RaymondBE/Electiva_Mecatronica_Raymond_Bautista_2019-8348-/README.md

# Electiva_Mecatronica_Raymond_Bautista_2019-8348-
Repositorio correspondiente a la asignatura de Diseño Mecatrónico. Raymond Bautista Espinosa (2019-8348).

Saludos:
Este repositorio contiene mis entregas realizadas en la asignatura de Diseño Mecatrónico. Período: 2022-C2, Universidad: ITLA.
