RaymondBE/Electiva_Mecatronica_Raymond_Bautista_2019-8348-/LIFFY/BOM.xlsx

Part Number | References | Value | Footprint | Quantity
1 | C3, C4, C5, C6, C7, C9, C10, C11, C15, C18, C19 | 100n | C_0201_0603Metric | 11
2 | C1, C2 | 30p | C_0201_0603Metric | 2
3 | C16, C17 | 22µ | C_0805_2012Metric | 2
4 | C8 | 4.7µ | C_0805_2012Metric | 1
5 | C14 | 10µ | C_0805_2012Metric | 1
6 | R1, R2, R3, R5, R8, R11, R16, R17, R18, R19, R20, R21, R22, R23, R24 | 10K | R_0201_0603Metric | 15
7 | R12, R13, R14, R15 | 10 | R_0201_0603Metric | 4
8 | R6, R9, R10 | 1K | R_0201_0603Metric | 3
9 | R4 | 100K | R_0201_0603Metric | 1
10 | R7 | 1M | R_0201_0603Metric | 1
11 | L1 | 4.7µ | L_Bourns_SRN6045TA | 1
12 | L2 | 27n | L_0805_2012Metric | 1
13 | U1, U2 | LM358 | SOIC-8_3.9x4.9mm_P1.27mm | 2
14 | U3, U5 | PC817 | SMDIP-4_W7.62mm | 2
15 | U6, U8 | ULN2003A | SOIC-16_3.9x9.9mm_P1.27mm | 2
16 | U4 | MIC4427 | SOIC-8_3.9x4.9mm_P1.27mm | 1
17 | U7 | AP63205WU | TSOT-23-6 | 1
18 | Y1 | Crystal 4 MHz | Crystal_HC49-4H_Vertical | 1
19 | SW1 | SW_DIP_x04 | SW_DIP_SPSTx04_Slide_9.78x12.34mm_W8.61mm_P2.54mm | 1
20 | K1, K2, K3, K4 | FINDER-36.11 | Relay_SPDT_Finder_36.11 | 4
21 | Q1, Q2 | IRF3205 | TO-220-3_Vertical | 2
22 | RV1, RV2 | 100K_POT | Potentiometer_Bourns_3296Y_Vertical | 2
23 | IC1 | MC9S08MP16xLC | LQFP-32_7x7mm_P0.8mm | 1
24 | RV3 | Varistor_6V | C_0805_2012Metric | 1
25 | J1 | VIN | TerminalBlock_bornier-2_P5.08mm | 1
26 | J2 | pH | TerminalBlock_bornier-3_P5.08mm | 1
27 | J3 | TDS | TerminalBlock_bornier-3_P5.08mm | 1
28 | J4 | LDR_CONECTOR | TerminalBlock_bornier-2_P5.08mm | 1
29 | J5 | DHT11 | TerminalBlock_bornier-3_P5.08mm | 1
30 | J6 | LEVEL_SENSOR2 | TerminalBlock_bornier-2_P5.08mm | 1
31 | J7 | LEDBAR1 | TerminalBlock_bornier-2_P5.08mm | 1
32 | J8 | 5V_OUT | TerminalBlock_bornier-2_P5.08mm | 1
33 | J9 | LEVEL_SENSOR1 | TerminalBlock_bornier-2_P5.08mm | 1
34 | J10 | M1 | TerminalBlock_bornier-2_P5.08mm | 1
35 | J11 | M2 | TerminalBlock_bornier-2_P5.08mm | 1
36 | J12 | M3 | TerminalBlock_bornier-2_P5.08mm | 1
37 | J13 | LEDBAR2 | TerminalBlock_bornier-2_P5.08mm | 1
38 | J14 | VIN2 | TerminalBlock_bornier-2_P5.08mm | 1
39 | J15 | Program_Pins | PinHeader_1x04_P2.54mm_Vertical | 1
40 | J16 | CONN_I2C | PinHeader_1x04_P2.54mm_Vertical | 1
41 | J17 | M4 | TerminalBlock_bornier-2_P5.08mm | 1
42 | J18 | CON_REL1 | TerminalBlock_bornier-3_P5.08mm | 1
43 | J19 | CON_REL2 | TerminalBlock_bornier-3_P5.08mm | 1
44 | J20 | CON_REL3 | TerminalBlock_bornier-3_P5.08mm | 1
45 | J21 | CONN_UART | PinHeader_1x04_P2.54mm_Vertical | 1
46 | J22 | CON_REL4 | TerminalBlock_bornier-3_P5.08mm | 1
