RaymondBE/Electiva_Mecatronica_Raymond_Bautista_2019-8348-/(list of files, drawings)

Other design files:
LIFFY/KiCAD/LIFFY_KICAD/LIFFY_KICAD.dsn
