RaymondBE/Electiva_Mecatronica_Raymond_Bautista_2019-8348-/LIFFY/KiCAD/LIFFY_KICAD/LIFFY_KICAD.kicad_pcb

## KiCad design LIFFY/KiCAD/LIFFY_KICAD/LIFFY_KICAD.kicad_pcb (2022-07-22)

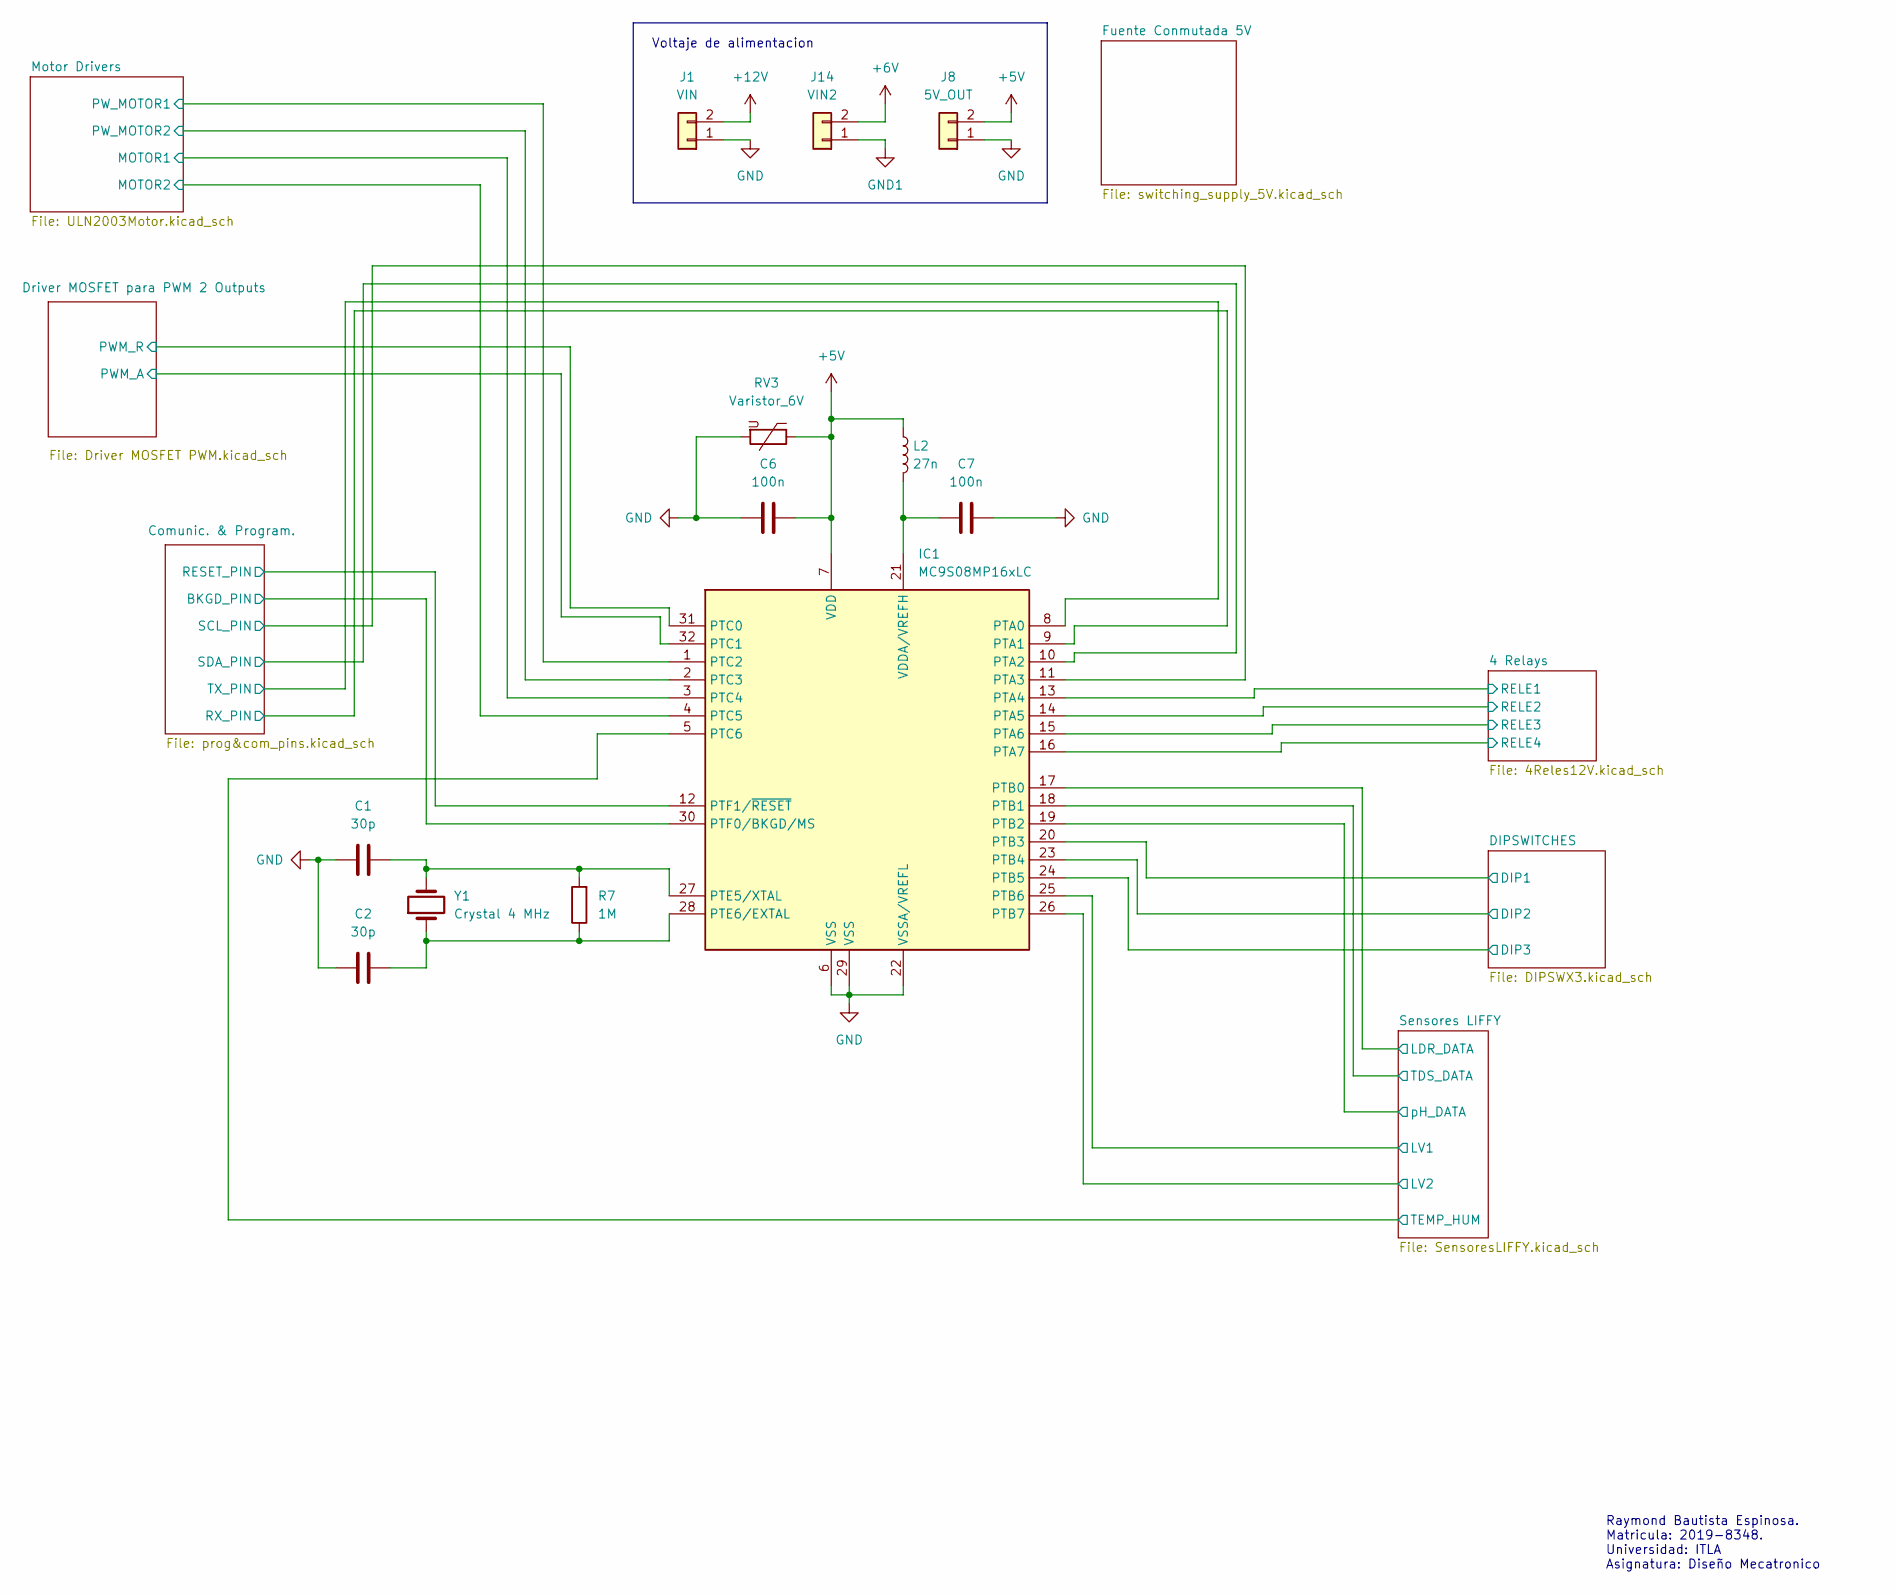
[picture p3: schematic LIFFY_KICAD.kicad_sch]

Parts:
C1, C2: 30p; C_0201_0603Metric
C6, C7: 100n; C_0201_0603Metric
IC1: MC9S08MP16xLC; LQFP-32_7x7mm_P0.8mm
J1: VIN; TerminalBlock_bornier-2_P5.08mm
J8: 5V_OUT; TerminalBlock_bornier-2_P5.08mm
J14: VIN2; TerminalBlock_bornier-2_P5.08mm
L2: 27n; L_0805_2012Metric
R7: 1M; R_0201_0603Metric
RV3: Varistor_6V; C_0805_2012Metric
Y1: Crystal 4 MHz; Crystal_HC49-4H_Vertical

Connections:
+5V: C6.2, IC1.7 (VDD), J8.2, L2.1, RV3.1; also elsewhere on the board
+6V: J14.2; also elsewhere on the board
+12V: J1.2; also elsewhere on the board
/4 Relays/RELE1: IC1.13 (PTA4); also elsewhere on the board
/4 Relays/RELE2: IC1.14 (PTA5); also elsewhere on the board
/4 Relays/RELE3: IC1.15 (PTA6); also elsewhere on the board
/4 Relays/RELE4: IC1.16 (PTA7); also elsewhere on the board
/Comunic. & Program./BKGD_PIN: IC1.30 (PTF0/BKGD/MS); also elsewhere on the board
/Comunic. & Program./RESET_PIN: IC1.12 (PTF1/~RESET); also elsewhere on the board
/Comunic. & Program./RX_PIN: IC1.9 (PTA1); also elsewhere on the board
/Comunic. & Program./SCL_PIN: IC1.11 (PTA3); also elsewhere on the board
/Comunic. & Program./SDA_PIN: IC1.10 (PTA2); also elsewhere on the board
/Comunic. & Program./TX_PIN: IC1.8 (PTA0); also elsewhere on the board
/DIPSWITCHES/DIP1: IC1.20 (PTB3); also elsewhere on the board
/DIPSWITCHES/DIP2: IC1.23 (PTB4); also elsewhere on the board
/DIPSWITCHES/DIP3: IC1.24 (PTB5); also elsewhere on the board
/Driver MOSFET para PWM 2 Outputs/PWM_A: IC1.32 (PTC1); also elsewhere on the board
/Driver MOSFET para PWM 2 Outputs/PWM_R: IC1.31 (PTC0); also elsewhere on the board
/Motor Drivers/MOTOR1: IC1.3 (PTC4); also elsewhere on the board
/Motor Drivers/MOTOR2: IC1.4 (PTC5); also elsewhere on the board
/Motor Drivers/PW_MOTOR1: IC1.1 (PTC2); also elsewhere on the board
/Motor Drivers/PW_MOTOR2: IC1.2 (PTC3); also elsewhere on the board
/Sensores LIFFY/LDR_DATA: IC1.17 (PTB0); also elsewhere on the board
/Sensores LIFFY/LV1: IC1.25 (PTB6); also elsewhere on the board
/Sensores LIFFY/LV2: IC1.26 (PTB7); also elsewhere on the board
/Sensores LIFFY/TDS_DATA: IC1.18 (PTB1); also elsewhere on the board
/Sensores LIFFY/TEMP_HUM: IC1.5 (PTC6); also elsewhere on the board
/Sensores LIFFY/pH_DATA: IC1.19 (PTB2); also elsewhere on the board
GND: C1.1, C2.1, C6.1, C7.1, IC1.6 (VSS), IC1.22 (VSSA/VREFL), IC1.29 (VSS), J1.1, J8.1, RV3.2; also elsewhere on the board
GND1: J14.1; also elsewhere on the board
unnamed: C1.2, IC1.27 (PTE5/XTAL), R7.2, Y1.2
unnamed: C2.2, IC1.28 (PTE6/EXTAL), R7.1, Y1.1
unnamed: C7.2, IC1.21 (VDDA/VREFH), L2.2

Notes on the sheet:
Raymond Bautista Espinosa. Matricula: 2019-8348. Universidad: ITLA Asignatura: Diseño Mecatronico
Voltaje de alimentacion

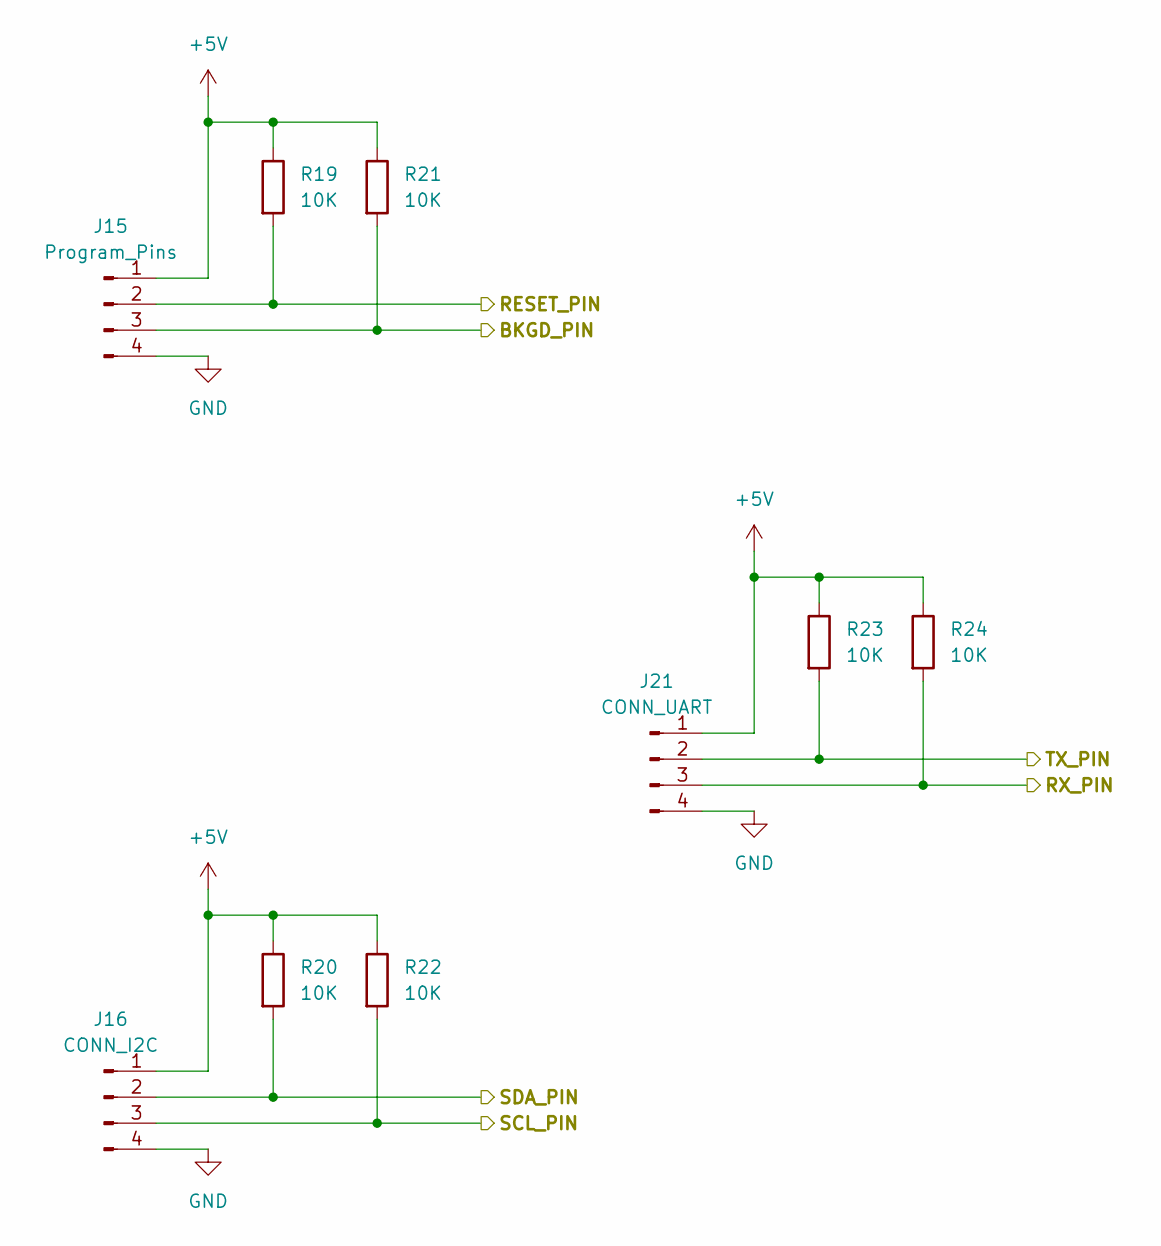
[picture p4: schematic prog&com_pins.kicad_sch]

Parts:
J15: Program_Pins; PinHeader_1x04_P2.54mm_Vertical
J16: CONN_I2C; PinHeader_1x04_P2.54mm_Vertical
J21: CONN_UART; PinHeader_1x04_P2.54mm_Vertical
R19, R20, R21, R22, R23, R24: 10K; R_0201_0603Metric

Connections:
+5V: J15.1, J16.1, J21.1, R19.1, R20.1, R21.1, R22.1, R23.1, R24.1; also elsewhere on the board
/Comunic. & Program./BKGD_PIN: J15.3, R21.2; also elsewhere on the board
/Comunic. & Program./RESET_PIN: J15.2, R19.2; also elsewhere on the board
/Comunic. & Program./RX_PIN: J21.3, R24.2; also elsewhere on the board
/Comunic. & Program./SCL_PIN: J16.3, R22.2; also elsewhere on the board
/Comunic. & Program./SDA_PIN: J16.2, R20.2; also elsewhere on the board
/Comunic. & Program./TX_PIN: J21.2, R23.2; also elsewhere on the board
GND: J15.4, J16.4, J21.4; also elsewhere on the board

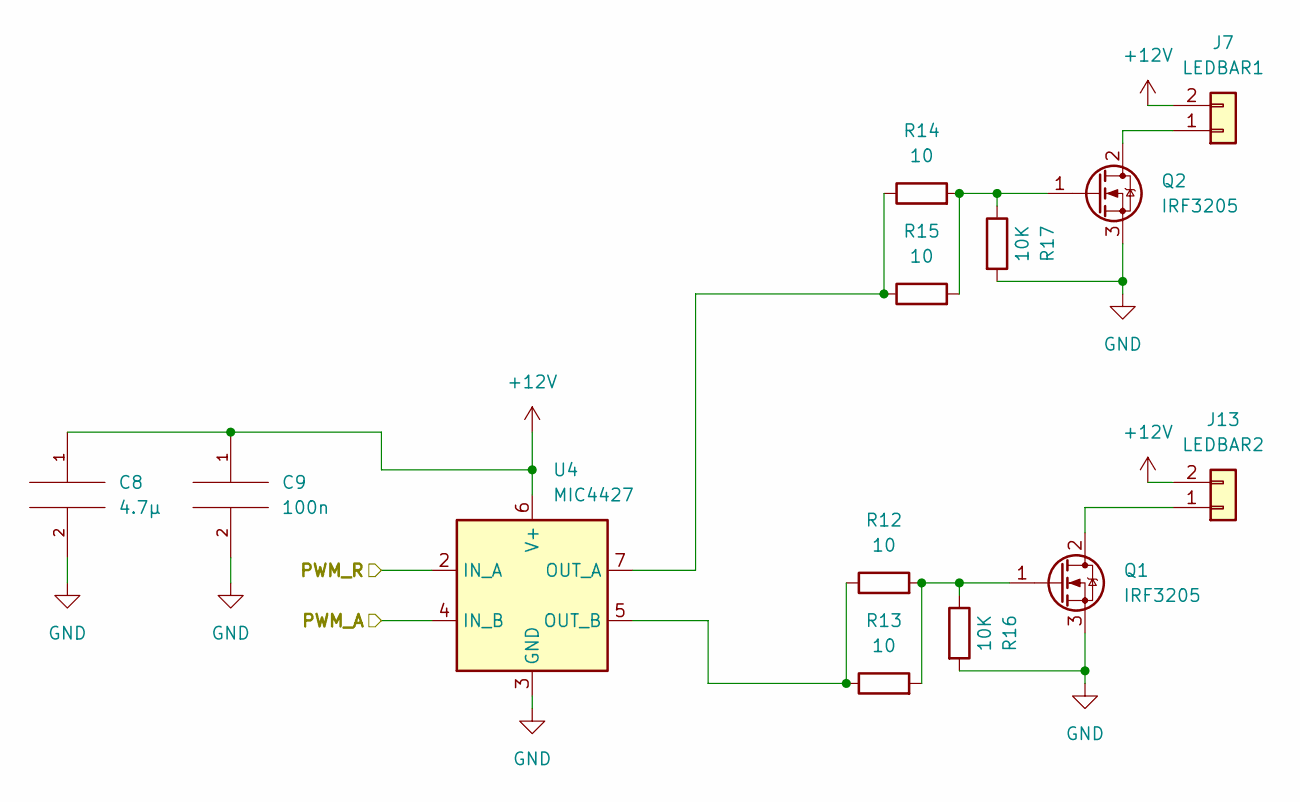
[picture p5: schematic Driver MOSFET PWM.kicad_sch]

Parts:
C8: 4.7µ; C_0805_2012Metric
C9: 100n; C_0201_0603Metric
J7: LEDBAR1; TerminalBlock_bornier-2_P5.08mm
J13: LEDBAR2; TerminalBlock_bornier-2_P5.08mm
Q1, Q2: IRF3205; TO-220-3_Vertical
R12, R13, R14, R15: 10; R_0201_0603Metric
R16, R17: 10K; R_0201_0603Metric
U4: MIC4427; SOIC-8_3.9x4.9mm_P1.27mm

Connections:
+12V: C8.1, C9.1, J7.2, J13.2, U4.6 (V+); also elsewhere on the board
/Driver MOSFET para PWM 2 Outputs/PWM_A: U4.4 (IN_B); also elsewhere on the board
/Driver MOSFET para PWM 2 Outputs/PWM_R: U4.2 (IN_A); also elsewhere on the board
GND: C8.2, C9.2, Q1.3 (S), Q2.3 (S), R16.2, R17.2, U4.3 (GND); also elsewhere on the board
unnamed: J7.1, Q2.2 (D)
unnamed: J13.1, Q1.2 (D)
unnamed: Q1.1 (G), R12.2, R13.2, R16.1
unnamed: Q2.1 (G), R14.2, R15.2, R17.1
unnamed: R12.1, R13.1, U4.5 (OUT_B)
unnamed: R14.1, R15.1, U4.7 (OUT_A)

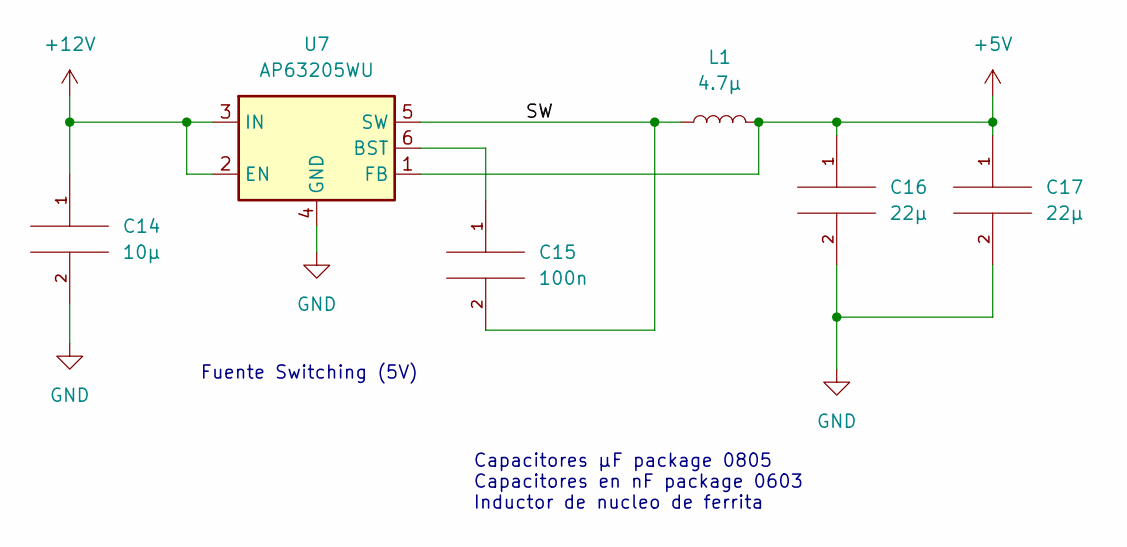
[picture p6: schematic switching_supply_5V.kicad_sch]

Parts:
C14: 10µ; C_0805_2012Metric
C15: 100n; C_0201_0603Metric
C16, C17: 22µ; C_0805_2012Metric
L1: 4.7µ; L_Bourns_SRN6045TA
U7: AP63205WU; TSOT-23-6

Connections:
+5V: C16.1, C17.1, L1.2, U7.1 (FB); also elsewhere on the board
+12V: C14.1, U7.2 (EN), U7.3 (IN); also elsewhere on the board
/Fuente Conmutada 5V/SW: C15.2, L1.1, U7.5 (SW)
GND: C14.2, C16.2, C17.2, U7.4 (GND); also elsewhere on the board
unnamed: C15.1, U7.6 (BST)

Notes on the sheet:
Fuente Switching (5V)
Capacitores µF package 0805 Capacitores en nF package 0603 Inductor de nucleo de ferrita

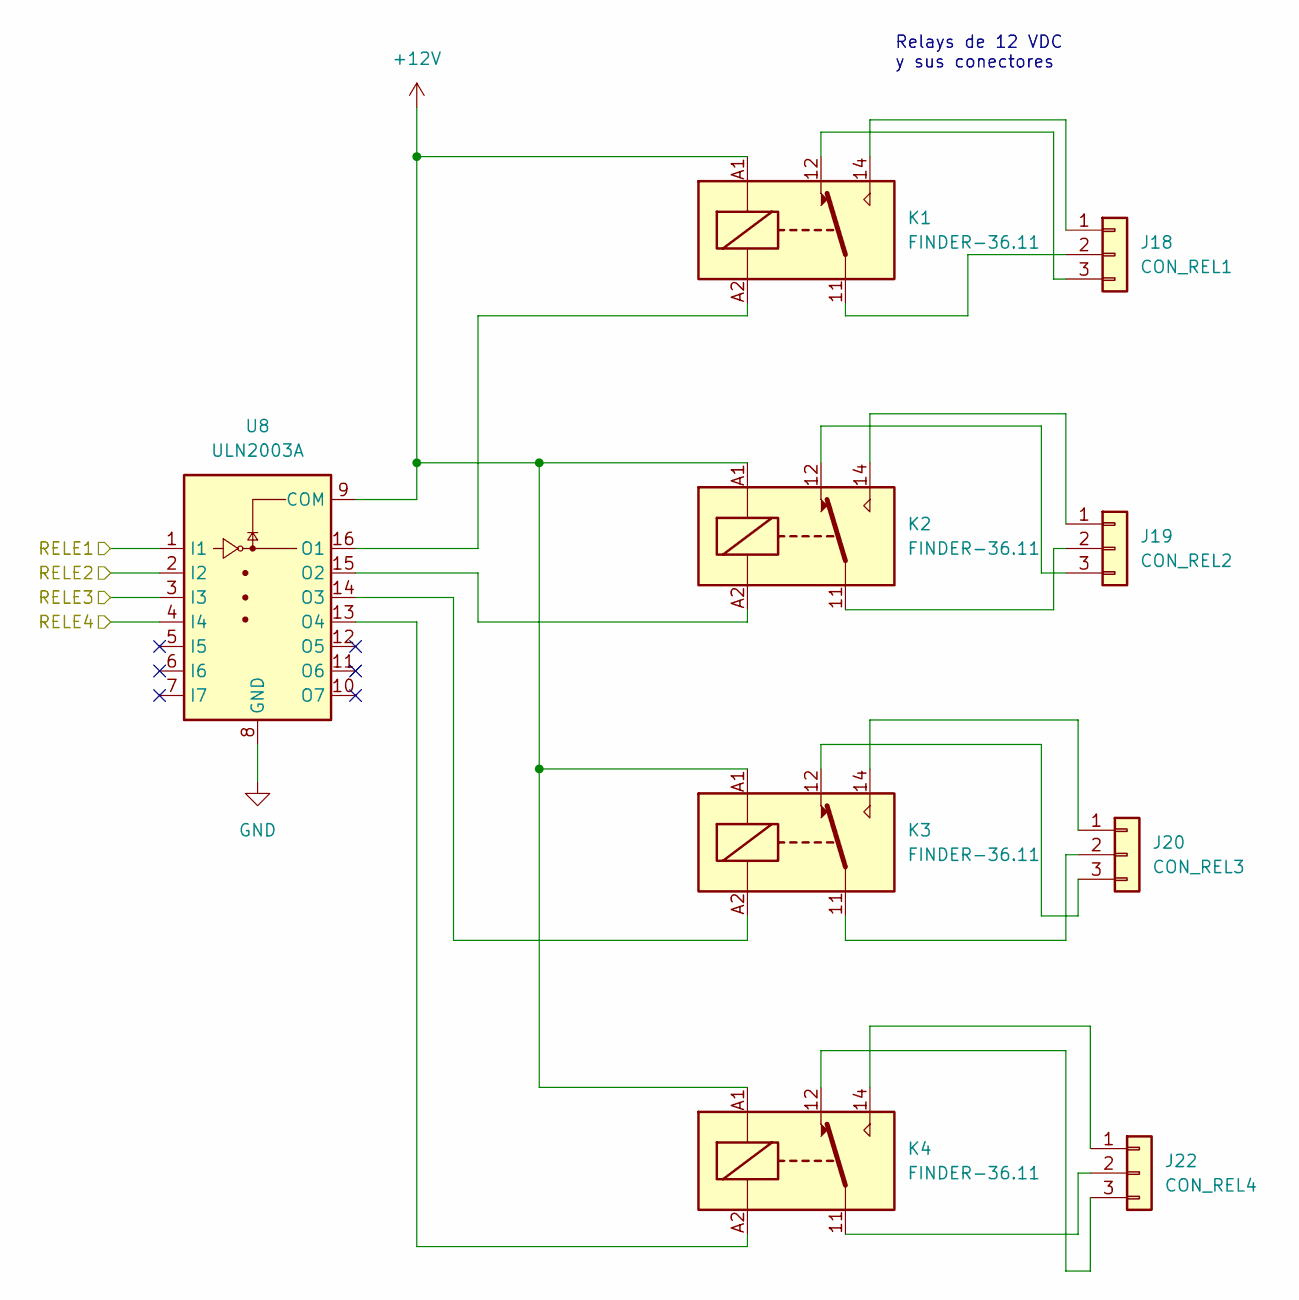
[picture p7: schematic 4Reles12V.kicad_sch]

Parts:
J18: CON_REL1; TerminalBlock_bornier-3_P5.08mm
J19: CON_REL2; TerminalBlock_bornier-3_P5.08mm
J20: CON_REL3; TerminalBlock_bornier-3_P5.08mm
J22: CON_REL4; TerminalBlock_bornier-3_P5.08mm
K1, K2, K3, K4: FINDER-36.11; Relay_SPDT_Finder_36.11
U8: ULN2003A; SOIC-16_3.9x9.9mm_P1.27mm

Connections:
+12V: K1.A1, K2.A1, K3.A1, K4.A1, U8.9 (COM); also elsewhere on the board
/4 Relays/RELE1: U8.1 (I1); also elsewhere on the board
/4 Relays/RELE2: U8.2 (I2); also elsewhere on the board
/4 Relays/RELE3: U8.3 (I3); also elsewhere on the board
/4 Relays/RELE4: U8.4 (I4); also elsewhere on the board
GND: U8.8 (GND); also elsewhere on the board
unnamed: J18.1, K1.14
unnamed: J18.2, K1.11
unnamed: J18.3, K1.12
unnamed: J19.1, K2.14
unnamed: J19.2, K2.11
unnamed: J19.3, K2.12
unnamed: J20.1, K3.14
unnamed: J20.2, K3.11
unnamed: J20.3, K3.12
unnamed: J22.1, K4.14
unnamed: J22.2, K4.11
unnamed: J22.3, K4.12
unnamed: K1.A2, U8.16 (O1)
unnamed: K2.A2, U8.15 (O2)
unnamed: K3.A2, U8.14 (O3)
unnamed: K4.A2, U8.13 (O4)

Notes on the sheet:
Relays de 12 VDC y sus conectores

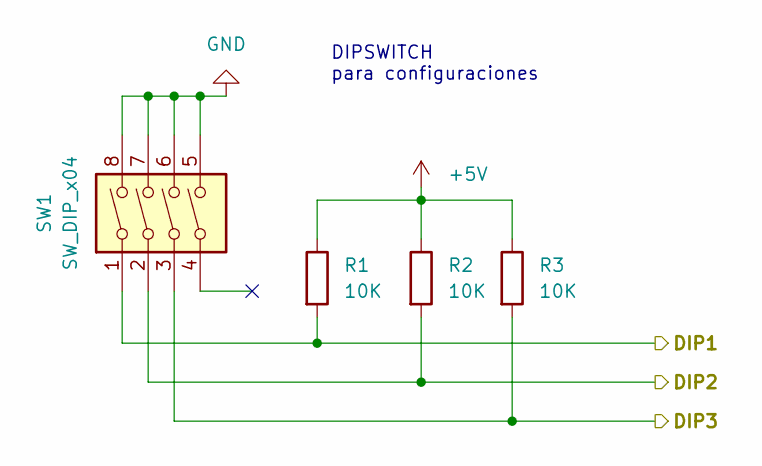
[picture p8: schematic DIPSWX3.kicad_sch]

Parts:
R1, R2, R3: 10K; R_0201_0603Metric
SW1: SW_DIP_x04; SW_DIP_SPSTx04_Slide_9.78x12.34mm_W8.61mm_P2.54mm

Connections:
+5V: R1.1, R2.1, R3.1; also elsewhere on the board
/DIPSWITCHES/DIP1: R1.2, SW1.1; also elsewhere on the board
/DIPSWITCHES/DIP2: R2.2, SW1.2; also elsewhere on the board
/DIPSWITCHES/DIP3: R3.2, SW1.3; also elsewhere on the board
GND: SW1.5, SW1.6, SW1.7, SW1.8; also elsewhere on the board

Notes on the sheet:
DIPSWITCH para configuraciones

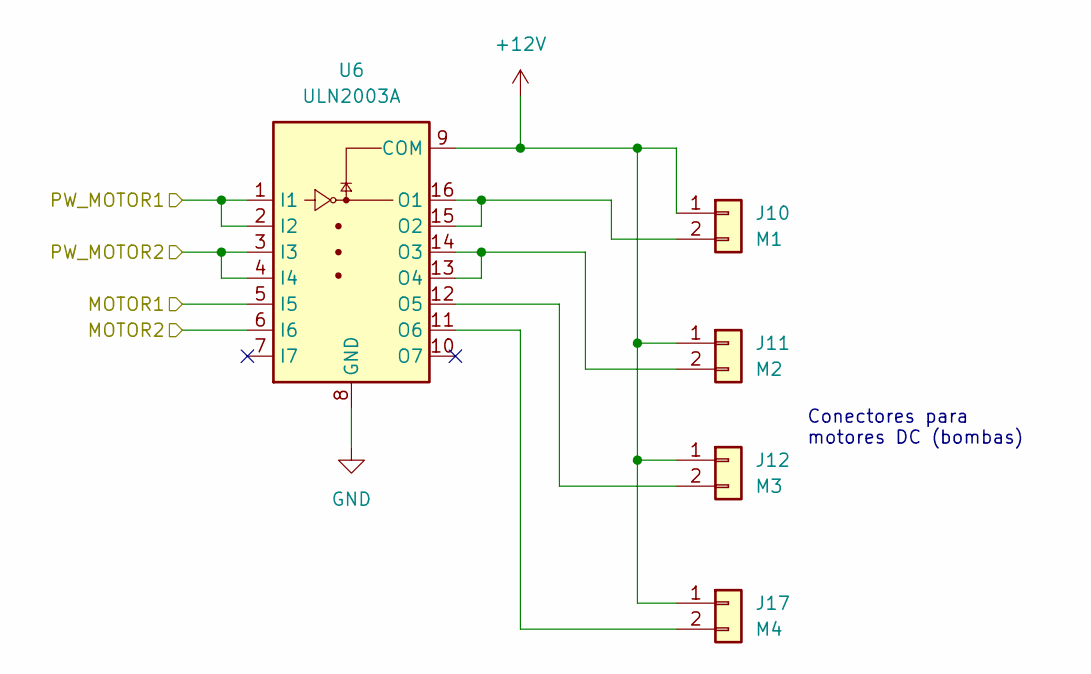
[picture p9: schematic ULN2003Motor.kicad_sch]

Parts:
J10: M1; TerminalBlock_bornier-2_P5.08mm
J11: M2; TerminalBlock_bornier-2_P5.08mm
J12: M3; TerminalBlock_bornier-2_P5.08mm
J17: M4; TerminalBlock_bornier-2_P5.08mm
U6: ULN2003A; SOIC-16_3.9x9.9mm_P1.27mm

Connections:
+12V: J10.1, J11.1, J12.1, J17.1, U6.9 (COM); also elsewhere on the board
/Motor Drivers/MOTOR1: U6.5 (I5); also elsewhere on the board
/Motor Drivers/MOTOR2: U6.6 (I6); also elsewhere on the board
/Motor Drivers/PW_MOTOR1: U6.1 (I1), U6.2 (I2); also elsewhere on the board
/Motor Drivers/PW_MOTOR2: U6.3 (I3), U6.4 (I4); also elsewhere on the board
GND: U6.8 (GND); also elsewhere on the board
unnamed: J10.2, U6.15 (O2), U6.16 (O1)
unnamed: J11.2, U6.13 (O4), U6.14 (O3)
unnamed: J12.2, U6.12 (O5)
unnamed: J17.2, U6.11 (O6)

Notes on the sheet:
Conectores para motores DC (bombas)

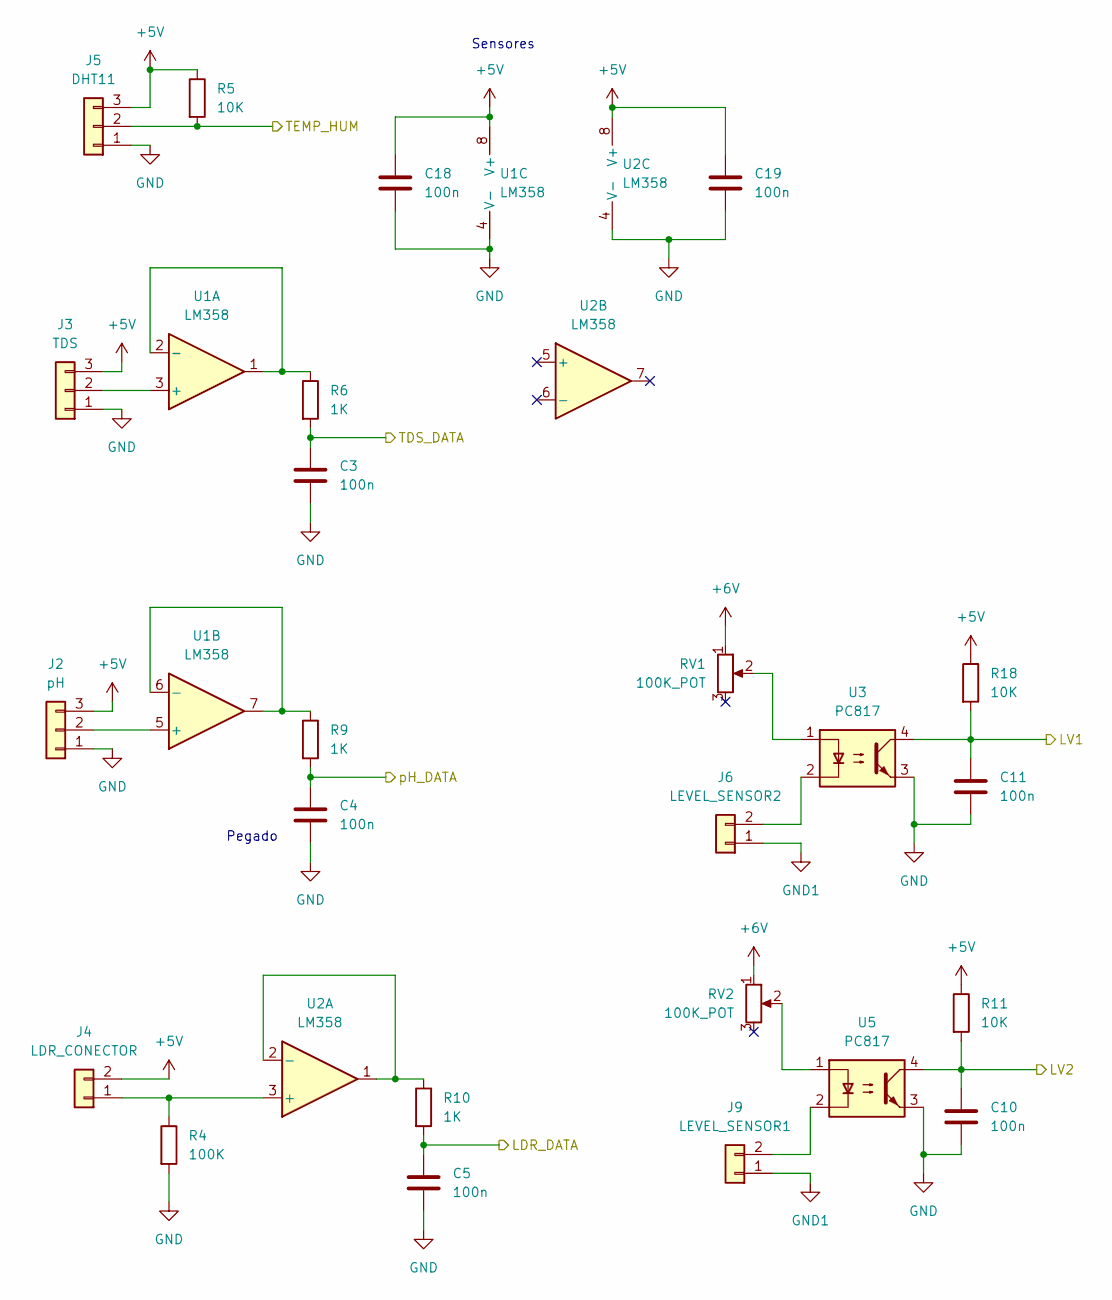
[picture p10: schematic SensoresLIFFY.kicad_sch]

Parts:
C3, C4, C5, C10, C11, C18, C19: 100n; C_0201_0603Metric
J2: pH; TerminalBlock_bornier-3_P5.08mm
J3: TDS; TerminalBlock_bornier-3_P5.08mm
J4: LDR_CONECTOR; TerminalBlock_bornier-2_P5.08mm
J5: DHT11; TerminalBlock_bornier-3_P5.08mm
J6: LEVEL_SENSOR2; TerminalBlock_bornier-2_P5.08mm
J9: LEVEL_SENSOR1; TerminalBlock_bornier-2_P5.08mm
R4: 100K; R_0201_0603Metric
R5, R11, R18: 10K; R_0201_0603Metric
R6, R9, R10: 1K; R_0201_0603Metric
RV1, RV2: 100K_POT; Potentiometer_Bourns_3296Y_Vertical
U1, U2: LM358; SOIC-8_3.9x4.9mm_P1.27mm
U3, U5: PC817; SMDIP-4_W7.62mm

Connections:
+5V: C18.1, C19.1, J2.3, J3.3, J4.2, J5.3, R5.1, R11.1, R18.1, U1.8 (V+), U2.8 (V+); also elsewhere on the board
+6V: RV1.1, RV2.1; also elsewhere on the board
/Sensores LIFFY/LDR_DATA: C5.1, R10.2; also elsewhere on the board
/Sensores LIFFY/LV1: C11.1, R18.2, U3.4; also elsewhere on the board
/Sensores LIFFY/LV2: C10.1, R11.2, U5.4; also elsewhere on the board
/Sensores LIFFY/TDS_DATA: C3.1, R6.2; also elsewhere on the board
/Sensores LIFFY/TEMP_HUM: J5.2, R5.2; also elsewhere on the board
/Sensores LIFFY/pH_DATA: C4.1, R9.2; also elsewhere on the board
GND: C3.2, C4.2, C5.2, C10.2, C11.2, C18.2, C19.2, J2.1, J3.1, J5.1, R4.2, U1.4 (V-), U2.4 (V-), U3.3, U5.3; also elsewhere on the board
GND1: J6.1, J9.1; also elsewhere on the board
unnamed: J2.2, U1.5 (+)
unnamed: J3.2, U1.3 (+)
unnamed: J4.1, R4.1, U2.3 (+)
unnamed: J6.2, U3.2
unnamed: J9.2, U5.2
unnamed: R6.1, U1.1, U1.2 (-)
unnamed: R9.1, U1.6 (-), U1.7
unnamed: R10.1, U2.1, U2.2 (-)
unnamed: RV1.2, U3.1
unnamed: RV2.2, U5.1

Notes on the sheet:
Sensores
Pegado

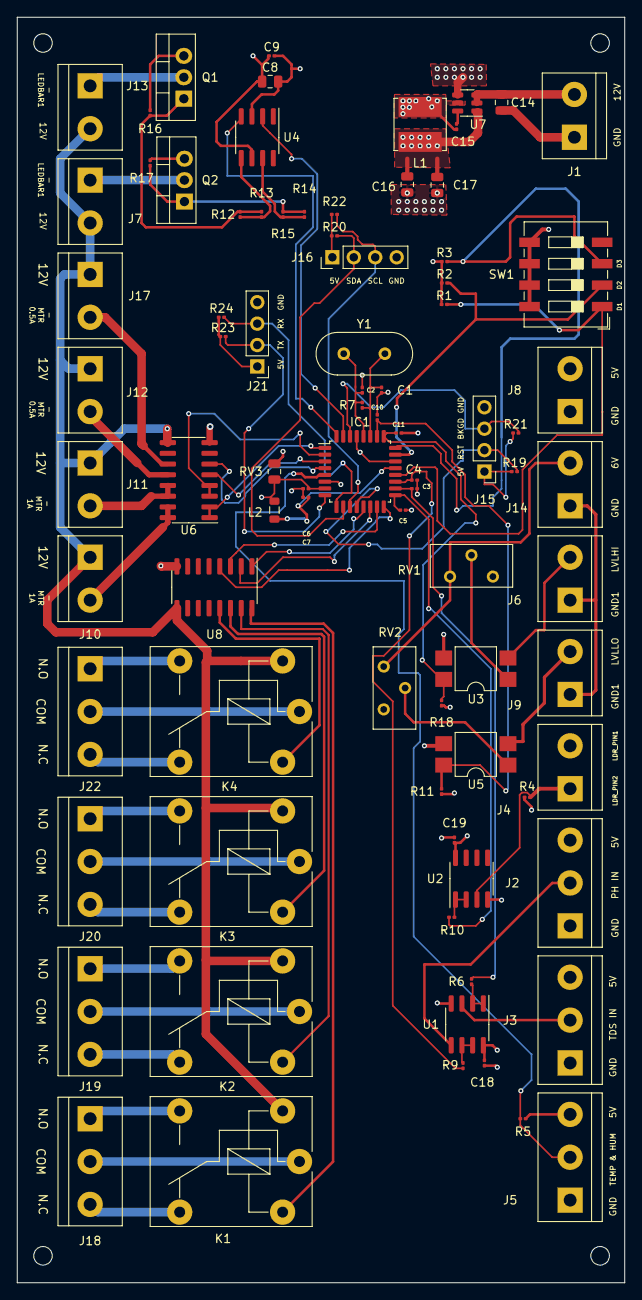
[picture p11: board LIFFY_KICAD.kicad_pcb from above]

Board: 4 copper layers, 72.0 x 150.0 mm, 88 parts (0 on the bottom side), 71 nets.

Other parts of the board:
HOLE1, HOLE2, HOLE3, HOLE4: MountingHole_2.2mm_M2
