RaymondBE/Electiva_Mecatronica_Raymond_Bautista_2019-8348-/(commit log)

2022-06-09 Version 1 de la plantilla de requisitos.
2022-06-09 Logo de MI Controller Solutions
2022-06-09 Elimine el logo
2022-06-10 Notas de Investigación V1
2022-07-08 V1 LIFFY Files
    [4Reles12V.kicad_sch, BOM.xlsx, DIPSWX3.kicad_sch, Driver MOSFET PWM.kicad_sch, LIFFY_KICAD.dsn, LIFFY_KICAD.kicad_pcb, LIFFY_KICAD.kicad_sch, SensoresLIFFY.kicad_sch]
2022-07-15 V2 PCB ADDED
    [4Reles12V.kicad_sch, BOM.xlsx, Driver MOSFET PWM.kicad_sch, LIFFY_KICAD.kicad_pcb, LIFFY_KICAD.kicad_sch, SensoresLIFFY.kicad_sch, ULN2003Motor.kicad_sch, prog&com_pins.kicad_sch]
2022-07-22 V3 Fixed
    [4Reles12V.kicad_sch, Driver MOSFET PWM.kicad_sch, LIFFY_KICAD.kicad_pcb, LIFFY_KICAD.kicad_sch, SensoresLIFFY.kicad_sch, ULN2003Motor.kicad_sch, prog&com_pins.kicad_sch, switching_supply_5V.kicad_sch]
2022-07-22 V4.5 Fixed
    [4Reles12V.kicad_sch, Driver MOSFET PWM.kicad_sch, LIFFY_KICAD.kicad_pcb, LIFFY_KICAD.kicad_sch, SensoresLIFFY.kicad_sch, ULN2003Motor.kicad_sch, prog&com_pins.kicad_sch, switching_supply_5V.kicad_sch]
2022-07-22 V5 Aprobado
    [LIFFY_KICAD.kicad_pcb]
2022-07-22 V6 Notas de silkscreen añadidas
    [LIFFY_KICAD.kicad_pcb]
2022-07-22 V7 Archivos Gerber añadidos
    [LIFFY_KICAD.kicad_pcb]
2022-07-25 V7.5 Gerber Added
    [LIFFY_KICAD-B_Cu.gbr, LIFFY_KICAD-B_Mask.gbr, LIFFY_KICAD-B_Paste.gbr, LIFFY_KICAD-B_Silkscreen.gbr, LIFFY_KICAD-Edge_Cuts.gbr, LIFFY_KICAD-F_Cu.gbr, LIFFY_KICAD-F_Mask.gbr, LIFFY_KICAD-F_Paste.gbr]
